lukasz-tuz/lowpolylight-cad/README.md

# lowpolylight-cad

CAD files for the lowpolylight panels and other devices.
