lukasz-tuz/lowpolylight-cad/src/lowpolylight-bom.ods

 | Comment | Designator | Description | LCSC | Unit Price | Ext. Price | Currency | Quantity | Total Price | Converted Price
Parts (JLC) | 100nF | C1,C5,C6 | Capacitor_SMD:C_0805_2012Metric_Pad1.18x1.45mm_HandSolder | C28233 | 0,0277 | 0,1656 | EUR | 6 | 0,1662 | 0,77283
 | 1uF | C2 | Capacitor_SMD:C_0805_2012Metric_Pad1.18x1.45mm_HandSolder | C28323 | 0,0873 | 0,1747 | EUR | 2 | 0,1746 | 0,81189
 | 22uF | C3 | Capacitor_SMD:C_1210_3225Metric_Pad1.33x2.70mm_HandSolder | C52306 | 0,9615 | 1,9229 | EUR | 2 | 1,923 | 8,94195
 | 100nF | C4 | Capacitor_SMD:C_1210_3225Metric_Pad1.33x2.70mm_HandSolder | C141218 | 1,1921 | 2,3841 | EUR | 2 | 2,3842 | 11,08653
 | 22uF | C7,C8 | Capacitor_SMD:C_0805_2012Metric_Pad1.18x1.45mm_HandSolder | C45783 | 0,1665 | 0,666 | EUR | 4 | 0,666 | 3,0969
 | 10k | R1 | Resistor_SMD:R_0805_2012Metric_Pad1.20x1.40mm_HandSolder | C17414 | 0,0218 | 0,0433 | EUR | 1 | 0,0433 | 0,201345
 | Reset | SW1 | Button_Switch_SMD:SW_SPST_B3U-1000P | C231329 | 1,183 | 4,7318 | EUR | 1 | 4,7318 | 22,00287
 | Boot Option | SW2 | Button_Switch_SMD:SW_SPST_B3U-1000P | C231329 | 1,183 | 4,7318 | EUR | 1 | 4,7318 | 22,00287
 | AMS1117-3.3 | U1 | Package_TO_SOT_SMD:SOT-223-3_TabPin2 | C6186 | 0,2366 | 0,4733 | EUR | 2 | 0,4732 | 2,20038
 | ESP32-WROOM-32E | U2 | Espressif:ESP32-WROOM-32E | C701343 | 4,4287 | 8,8574 | EUR | 2 | 17,7148 | 82,37382
PCB & SMT | lowpolylight-controller-manuf_Y14 | Y14-3441548 | PCB Manufacturing |  | 0,354 |  | EUR | 1 | 0,354 | 1,6461
 | lowpolylight-controller-manuf_Y14 | SMT0220219609747 | Setup fee |  | 3,53 |  | EUR | 1 | 3,53 | 16,4145
 |  |  | Stencil |  | 0,66 |  | EUR | 1 | 0,66 | 3,069
 |  |  | Components |  | 9,445 |  | EUR | 1 | 9,445 | 43,91925
 |  |  | Extended components fee |  | 5,295 |  | EUR | 1 | 5,295 | 24,62175
 |  |  | SMT Assembly |  | 0,27 |  | EUR | 1 | 0,27 | 1,2555
Others | Panel frame |  | 3D print, ABS, high quality |  | 35,15 |  | PLN | 2 | 70,3 | 70,3
 | Panel back |  | Laser cutout, plexi, 3mm |  | 11 |  | PLN | 2 | 22 | 22
 | Panel front |  | Laser cutout, plexi, 2mm |  | 8,87 |  | PLN | 2 | 17,74 | 17,74
 | Controller case |  | 3D print, ABS, high quality |  | 25,71 |  | PLN | 1 | 25,71 | 25,71
 | Controller cover |  | Laser cutout, plexi, 2mm |  | 6,84 |  | PLN | 1 | 6,84 | 6,84
 | 5V 8A power supply |  |  |  | 89 |  | PLN | 1 | 89 | 89
 | WS2813 LED strip |  | 144 LED/m, 43,2W/m |  | 0,83 |  | PLN | 130 | 107,9 | 107,9
 | Conn_Coaxial_Power | J1 | Connector_BarrelJack:BarrelJack_Horizontal |  | 0,675 |  | PLN | 1 | 0,675 | 0,675
 | Serial | J2 | Connector_PinHeader_2.54mm:PinHeader_1x04_P2.54mm_Vertical |  | 0,0495 |  | PLN | 1 | 0,0495 | 0,0495
 | Right Panel | J3 | TE-Connectivity:119542892 |  | 7,3062 |  | PLN | 1 | 7,3062 | 7,3062
 | Left Panel | J4 | TE-Connectivity:119542892 |  | 7,3062 |  | PLN | 1 | 7,3062 | 7,3062
 | Conductive PET layer |  |  |  | 42,68 |  | PLN | 2 | 85,36 | 85,36
 |  |  |  |  |  |  |  |  |  | 531,113 | 485,75225
