lukasz-tuz/lowpolylight-cad/(list of files, cad)

Other CAD files:
src/panels-cad/lowpoly-waves.stl
