lukasz-tuz/lowpolylight-cad/src/controller-pcb/lowpolylight.kicad_pcb

## KiCad design src/controller-pcb/lowpolylight.kicad_pcb (2022-05-02)

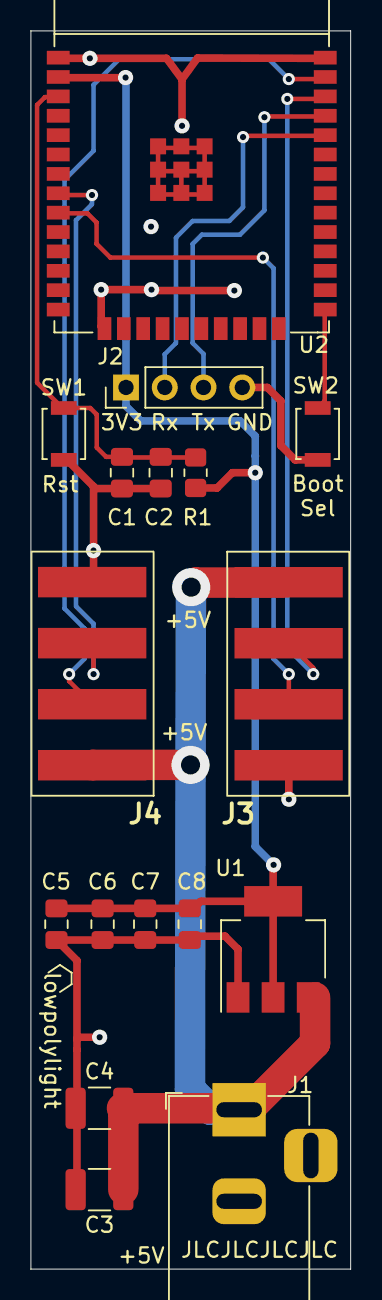
[picture p2: board lowpolylight.kicad_pcb from above]

Board: 2 copper layers, 21.0 x 81.2 mm, 17 parts (0 on the bottom side), 11 nets.

Parts:
C1, C5, C6: 100nF; C_0805_2012Metric_Pad1.18x1.45mm_HandSolder
C2: 1uF; C_0805_2012Metric_Pad1.18x1.45mm_HandSolder
C3: 22uF; C_1210_3225Metric_Pad1.33x2.70mm_HandSolder
C4: 100nF; C_1210_3225Metric_Pad1.33x2.70mm_HandSolder
C7, C8: 22uF; C_0805_2012Metric_Pad1.18x1.45mm_HandSolder
J1: Conn_Coaxial_Power; BarrelJack_Horizontal
J2: Serial; PinHeader_1x04_P2.54mm_Vertical
J3: Right Panel; 119542892
J4: Left Panel; 119542892
R1: 10k; R_0805_2012Metric_Pad1.20x1.40mm_HandSolder
SW1: Reset; SW_SPST_B3U-1000P
SW2: Boot Option; SW_SPST_B3U-1000P
U1: AMS1117-3.3; SOT-223-3_TabPin2
U2: ESP32-WROOM-32E

Connections:
+3V3: C5.2, C6.1, C7.2, C8.1, J2.1, R1.1, U1.2 (VO), U2.2 (3V3)
+5V: C3.1, C4.1, J1.1 (In), J3.1, J4.1, U1.3 (VI)
/RST: C1.2, C2.2, R1.2, SW1.2, U2.3 (EN/CHIP_PU)
/Rx: J2.2, U2.34 (U0RXD/GPIO3)
/Tx: J2.3, U2.35 (U0TXD/GPIO1)
GND: C1.1, C2.1, C3.2, C4.2, C5.1, C6.2, C7.1, C8.2, J1.2 (Ext), J2.4, J3.4, J4.4, SW1.1, SW2.1, U1.1 (GND), U2.1 (GND), U2.15 (GND), U2.38 (GND)
LED_L: J4.2, U2.37 (GPIO23)
LED_R: J3.2, U2.36 (GPIO22)
unnamed: SW2.2, U2.25 (GPIO0/BOOT/ADC2_CH1)
TOUCH_L: J4.3, U2.8 (32K_XP/GPIO32/ADC1_CH4)
TOUCH_R: J3.3, U2.9 (32K_XN/GPIO33/ADC1_CH5)
