lukasz-tuz/lowpolylight-cad/(commit log)

2022-03-27 Updating CAD files
    [butterfly.FCStd, butterfly.dxf, controller-cover.dxf, hexagon.FCStd, hexagon.dxf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]
2022-04-24 Repo cleanup
    [controller-cover.dxf, hexalight-bom.ods, hexalight.csv, lowpoly-butterfly-ControllerController base.stl, lowpoly-butterfly-ControllerController cover.stl, lowpoly-butterfly-ControllerWall 1.stl, lowpoly-butterfly-cutouts-controller.dxf, lowpoly-butterfly-cutouts-plexi.dxf]
2022-05-02 Name change
    [hexalight-Dolna opisowa.gbo, hexalight-Dolna pasty.gbp, hexalight-Dolna sodermaski.gbs, hexalight-Dolna sygnalowa.gbl, hexalight-Gorna opisowa.gto, hexalight-Gorna pasty.gtp, hexalight-Gorna soldermaski.gts, hexalight-Gorna sygnalowa.gtl]
2022-05-02 Updating README
    [lowpolylight-bom.ods]
2022-05-10 Initial commit of waves panel
    [lowpoly-waves.FCStd]
2022-07-06 Adding connector sockets to waves panel
    [lowpoly-waves.FCStd, lowpoly-waves.stl]
2022-07-21 Modifying layout of edge connectors
    [lowpoly-waves.FCStd, lowpoly-waves.stl]
